muchaste/EOD-Logger/images/logger_prototype.JPG

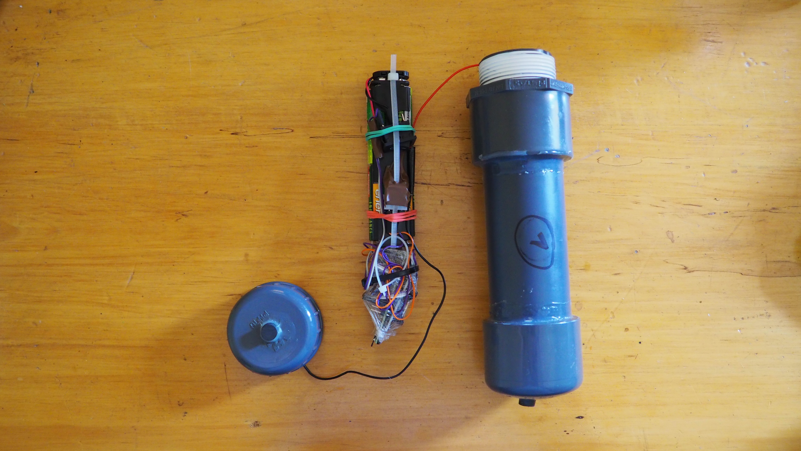
images/logger_prototype.JPG
