muchaste/EOD-Logger/eodlogger_1channel_singleended_barebone/eodlogger_1channel_singleended_barebone.ino

//*************************************************************************
// One channel EOD logger programm for testing purposes
// Barebone: no RTC
//*************************************************************************

#include <ADC.h>              //library for easier ADC implementation
#include <DMAChannel.h>       //library for easier DMA implementation
#include <array>              //use C++ array structs
#include <SdFat.h>            // work with SD card


/*----------------------------------------------------------------*/
const uint32_t pdbfreq = 100000;  // sampling speed [Hz] max ~300MHz - actually the trigger frequency of the programmable delay block
uint32_t duration = 10;           // duration of each measure-cycle [s]
String Name = "Log";              // file name prefix
unsigned long debug_start;
/*----------------------------------------------------------------*/

/*DECLARATIONS adc and pins---------------------------------------*/
ADC *adc = new ADC();                           // Declare adc object. Update: adc as pointer, use adc->adcX

/*PINS------------------------------------------------------------*/
const uint8_t adc_pin0 = A2;                    // A2 is connected to ADC0
/*----------------------------------------------------------------*/

/*Buffer declarations----------------------------------------------*/
std::array<volatile uint16_t, (uint32_t)128 * 512> buffer __attribute__ ((aligned (32 * 1024)));      // size of buffer is limited due to the Teensy's program memory

uint32_t      BUF_DIM       = 32768;                                          //size of buffer that holds data from ADC
uint32_t      FILE_SIZE     = 0;                                                  //initial variables for filesize and pointer to...
uint32_t      last          = 0;     
uint32_t      last1         = 0;     
uint32_t      bytes         = 0;
float         preceil       = 0;
float         scale         = 0;
/*----------------------------------------------------------------*/

/*DECLARATIONS dma and tcd----------------------------------------*/
DMAChannel dma;                                 // used to declare the dma.### object for the first channel

typeof(*dma.TCD)  tcd_mem[4] __attribute__ ((aligned (32))) ;   // alignment of four 32-byte blocks; needed for four different TCDs
/*----------------------------------------------------------------*/

/*DECLARATIONS for Interrupt Service Routine (ISR)----------------*/
// The transfer of data from the buffer to the SD card is initiated via an interrupt service routine

uint32_t dma0_isr_counter = 0;                  // counter that will be incremented after a major loop completion (hardware)

uint32_t old_dma0_isr_counter = 0;              // counter that is compared to the dma0_isr_counter to register the hardware increment

uint32_t bufPtr = 0;                            // pointer to the buffer section in which the data is currently transferred
/*----------------------------------------------------------------*/

//  DMA interrupt service routines
/*----------------------------------------------------------------*/
void dma0_isr(void) {                              // method that deletes interrupt and increments a counter; method is later attached to the resepctive dma channel via  dma.attachInterrupt(dma0_isr);
  dma.clearInterrupt();
  dma0_isr_counter++;
}
/*----------------------------------------------------------------*/

/*DECLARATIONS microSD card files---------------------------------*/
// SDCARD_SS_PIN is defined for the built-in SD on some boards.
//#ifndef SDCARD_SS_PIN
//const uint8_t SD_CS_PIN = 10;                 // set cs pin to 10 for SPI communication with SD card (ext.)
//#else  // SDCARD_SS_PIN
//const uint8_t SD_CS_PIN = SDCARD_SS_PIN;
//#endif  // SDCARD_SS_PIN
#define SD_CONFIG SdioConfig(FIFO_SDIO)
//#define SD_CONFIG SdSpiConfig(SD_CS_PIN, DEDICATED_SPI, SD_SCK_MHZ(50))


SdFs sd;                                    // used to declare the sd.### object (Sdfat); do not use SdFatSdioEX sd

uint16_t fileNr = 0;                             // after a given duration a new file is created; fileNr is an index used for the filename

FsFile file;                                       // file object for logging data
/*----------------------------------------------------------------*/


// function creates new files for data logging
/*----------------------------------------------------------------*/
void filestuff() {
  fileNr++;
  String filename = Name + "_dma0_" + fileNr + ".bin";
  char fname[30];
  filename.toCharArray(fname, 30);
  Serial.print("filename: ");
  Serial.println(filename);

  if (!file.open(fname, O_RDWR | O_CREAT)) {
    sd.errorHalt("open dma0 file failed");
  }
}


void setup() 
{
  /*Serial monitor--------------------------------------------------*/
  debug_start = millis();
  Serial.begin(115200);
  while ((millis() - debug_start) <= 5000);
  Serial.println("Begin Setup\n");
  /*----------------------------------------------------------------*/

  /*FileSetup-------------------------------------------------------*/
  String filename = Name + "_dma0_" + fileNr + ".bin";                        // create filenames
  char fname[30];
  filename.toCharArray(fname, 30);

  Serial.println(filename);
       
  if (!sd.begin(SD_CONFIG)) {     // Update: initiate SD card with FIFO_SDIO config
    sd.errorHalt("begin failed");
  }
  if (!file.open(fname, O_RDWR | O_CREAT)) {                                  // create SD card files
    sd.errorHalt("open dma0 failed");
  }


  delay(100);
  /*----------------------------------------------------------------*/

  /*DurationSetup---------------------------------------------------*/
  bytes = ((duration*1000000)/(1000000/pdbfreq))* 2; 
  preceil = bytes/BUF_DIM;
  scale = ceil(preceil);                                                    // round up preceil value
  FILE_SIZE = (scale+2) * BUF_DIM;                                          // after writing FILE_SIZE uint16_t values to a file a new file is created
  /*----------------------------------------------------------------*/

  /*Mode Setup------------------------------------------------------*/
  pinMode(13, OUTPUT);                                                     // built-in LED is at PIN 13 in Teensy 3.5
  pinMode(adc_pin0, INPUT);                                                // configure as analog input pins
  /*----------------------------------------------------------------*/

  /*ADC Setup-------------------------------------------------------*/
  adc->adc0->startSingleRead(adc_pin0);                                    // start ADC conversion (updated to pointer object)

  adc->adc0->setAveraging       (                              1  );       // ADC configuration
  adc->adc0->setResolution      (                              16 );
  adc->adc0->setConversionSpeed ( ADC_CONVERSION_SPEED::HIGH_SPEED);
  adc->adc0->setSamplingSpeed   ( ADC_SAMPLING_SPEED::HIGH_SPEED  );

  adc->adc0->setReference(ADC_REFERENCE::REF_3V3);                         // set analog reference
  /*----------------------------------------------------------------*/

  /* DMA ----------------------------------------------------------*/
  dma.source                 (           ADC0_RA);                         // source is the ADC result register
  dma.transferSize           (                 2);                         // set 2, one uint16_t value are two bytes
  dma.triggerAtHardwareEvent (DMAMUX_SOURCE_ADC0);                         // DMAMUX alignes source to DMA channel
  /*----------------------------------------------------------------*/
  
  /*TCD-------------------------------------------------------------*/

  // configure TCD for first dma
  dma.TCD->CITER    =           32 * 512;
  dma.TCD->BITER    =           32 * 512;
  dma.TCD->DOFF     =                  2;                                  // set 2, one uint16_t value are two bytes
  dma.TCD->CSR      =               0x10;
  dma.TCD->CSR |= DMA_TCD_CSR_INTMAJOR;                                     // enable interrupt after major loop completion

  dma.TCD->DADDR        = (volatile void*) &buffer [ 0 * 512]  ;
  dma.TCD->DLASTSGA     = (   int32_t    ) &tcd_mem[       1]  ;           // points to a 32-byte block that is loaded into the TCD memory of the DMA after major loop completion
  memcpy ( &tcd_mem[0], dma.TCD , 32 ) ;                                   // 32-byte block is transferred to &tcd_mem[0]

  dma.TCD->DADDR        = (volatile void*) &buffer [32 * 512]  ;
  dma.TCD->DLASTSGA     = (   int32_t    ) &tcd_mem[       2]  ;
  memcpy ( &tcd_mem[1], dma.TCD , 32 ) ;

  dma.TCD->DADDR        = (volatile void*) &buffer [64 * 512]  ;
  dma.TCD->DLASTSGA     = (   int32_t    ) &tcd_mem[       3]  ;
  memcpy ( &tcd_mem[2], dma.TCD , 32 ) ;

  dma.TCD->DADDR        = (volatile void*) &buffer [96 * 512]  ;
  dma.TCD->DLASTSGA     = (   int32_t    ) &tcd_mem[       0]  ;
  memcpy ( &tcd_mem[3], dma.TCD , 32 )  ;

  memcpy ( dma.TCD ,  &tcd_mem[0], 32 ) ;                                  // 16-byte block that is transferred into the TCD memory of the DMA


  /*Start DMA and ADC-----------------------------------------------*/
  dma.enable();                                                             // enable DMA
  dma.attachInterrupt(dma0_isr);                                            // attach interrupt that is done after major loop completion

  adc->adc0->enableDMA();                                                     // connect DMA and ADC
  adc->adc0->stopPDB();                                                      // start PDB conversion trigger
  adc->adc0->startPDB(pdbfreq);
  /*----------------------------------------------------------------*/


  /*Debug-----------------------------------------------------------*/
  Serial.println(BUF_DIM);
  Serial.println("----------------------------------");
  /*----------------------------------------------------------------*/

  /*Signal end of Setup method--------------------------------------*/
  for (int i = 0; i < 5; i++){                                             // visual feedback, blink 5 times if the setup was completed
    digitalWrite(13, HIGH);
    delay(300);
    digitalWrite(13, LOW);
    delay(300);
  }
}


void loop() {  
  if (dma0_isr_counter != old_dma0_isr_counter){                              // check if buffer section can be written on microSD card
    if (BUF_DIM != (uint32_t)file.write( (char*)&buffer[((last/2)&(64*1024-1))], BUF_DIM) ){ 
      sd.errorHalt("write dma0 failed");    
      }
    last += BUF_DIM ;  
    old_dma0_isr_counter++;                                                  // increment counter so that it matches dma0_isr_counter
  } 
  /*----------------------------------------------------------------*/
  if ( last >= FILE_SIZE ) {                                              // check if end of file is reached
    file.close();
    last = 0;                                                             // reset last
    filestuff();                                                          // create new files for data logging
    digitalWrite(13, HIGH);
    delay(5000);
    digitalWrite(13, LOW);
  }
  /*----------------------------------------------------------------*/
}
