muchaste/EOD-Logger/(commit log)

2019-11-18 First working version of EOD logger sketch. Uses DMA to pass differential voltage readings from analog inputs into a dynamic buffer that is periodically pushed on the SD card.
2020-02-13 added new 2 channel/dma version
2020-10-14 improved wiring sketch
2020-10-14 renamed sketch, added circuit image
2020-10-14 Line 115: added missing {, line 427: added missing +;
    [eodlogger-2channel.ino]
2020-10-15 Reverted to SdFatSdioEX to prevent write error, removed interrupt routine
    [eodlogger_2channel_barebone.ino]
2020-10-16 Corrected error in buffer pointer arithmetics, ADC0 looks good, ADC1 extremely noisy
    [eodlogger_2channel_barebone.ino]
2020-11-04 Add files via upload
    First try to create an EOD-Logger with 8-Channels
    Current Version: Added new DMA's, Pins etc. to the Setup
    TO DO: Complete Setup, adjust the loop accordingly
2020-12-01 Adjusted to recent versions of SDfat and ADC libraries
2020-12-01 2 channel single-ended recording using v 1.1 Sdfat lib and Arduino 1.8.8
2021-01-15 Differential recording that works with the new adc lib and supports exFat microSD cards
2021-01-15 Single-ended recording that works with the new adc lib and supports exFat microSD cards
2021-01-18 Fixed copy paste errors
    [eodlogger_1channel_diff_DS3231.ino]
2021-01-20 Delay at end of setup interfered with first measurement - fixed.
    [eodlogger_2channel_DS3231.ino]
2021-05-14 Corrected small typo in preamble
    [eodlogger_1channel_singleended_barebone.ino]
2021-06-30 added LED blinking patterns to README
2021-07-08 configurable logger
    [logger.cfg]
